dlgus0630/Project02_Elevator/(commit log)

2026-07-19 Complete 3-layer refactor, add I2C LCD, inspection mode, RGB scheme
    3계층 아키텍처 리네이밍 완료(Core/*.c -> BSP/dev_*.c, modbus.c ->
    app_rs485_ctrl.c, main.c의 FSM 로직을 app_elevator_fsm.c로 추출).
    FND/LED 개별 모듈은 dev_display.c(RGB+FND+LED바+I2C LCD 통합)으로 흡수.
    - I2C1 1602 LCD 추가(PCF8574 백팩), 미장착 시 타임아웃으로 IWDG 리셋
    루프 방지, I2C_Scan 디버그 헬퍼
    - 점검(Inspection) 모드 추가: ELEV_STATE_INSPECTION/REG_INSPECTION,
    FND '-' 표시, 물리 비상정지가 항상 우선하는 가드, ERROR/INSPECTION
    진입 시 자동 문열림·해제 시 자동 문닫힘
    - 3색 상태 LED 색상 확정: 대기=초록,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
    [Project02_Elevator.ioc, app_elevator_fsm.c, app_elevator_fsm.h, app_rs485_ctrl.c, app_rs485_ctrl.h, dev_button.c, dev_button.h, dev_buzzer.c]
2026-07-19 Add tiered error-code system (E101-E402) and distance-based move timeout
    - Compute REG_ERROR_CODE via sequential-override priority: environment
    (101/102/103, with 31/28C hysteresis on 101) -> 201 (move timeout)
    -> 301 (floor-skip) -> 402 (inspection) -> 401 (emergency, always
    wins). Report via new REG_ERROR_CODE(8) modbus register.
    - Detect E201 (move timeout) and E301 (floor skip on 1<->3 trips
    missing floor 2) in FSM_HandleMoving; both clear via the existing
    REG_EMERGENCY reset button, same as E401.
    - Split move timeout by distance: 60s for 1-floor moves, 120s for
    2-floor moves (1<->3), based on measured travel time.
    - Show code-specific text on the 1602 LCD and extend FND/RGB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
    [app_elevator_fsm.c, app_elevator_fsm.h, app_rs485_ctrl.c, app_rs485_ctrl.h, dev_display.c, dev_display.h, dev_photo.c, dev_photo.h]
2026-07-27 Simplify error-code display and floor-trip logic
    - Extract Apply_SensorErrorLine2() to remove the sensor-error LCD
    text block duplicated across IDLE/MOVING/DOOR_OPEN.
    - Extract Is_TwoFloorTrip() to remove the duplicated 1<->3 floor-pair
    check used by both the move-timeout selection and floor-skip
    detection.
    - Cache DHT_GetLastStatus() instead of calling it twice per tick.
    [app_elevator_fsm.c, app_elevator_fsm.h, dev_display.c]
2026-08-03 Remove dead code and stale debug diagnostics
    Drops unused functions (LCD_Clear), unused constants, a duplicate
    include, a stale comment describing already-removed variables, and
    the temporary RS485 debug printf statements now that communication
    is stable.
2026-08-04 Clean up stale and misleading comments
    Removes comments describing already-removed logic, translated-verbatim
    comments that add no information, and contradictory duplicate
    explanations. Rewrites kept comments for accuracy (FSM state meanings,
    Modbus register map, sensor/driver timing rationale) while keeping the
    project's existing Korean comment density.
